jimyu15/Jim-DCC/Hardware/DCC-headlight-V2.pdf

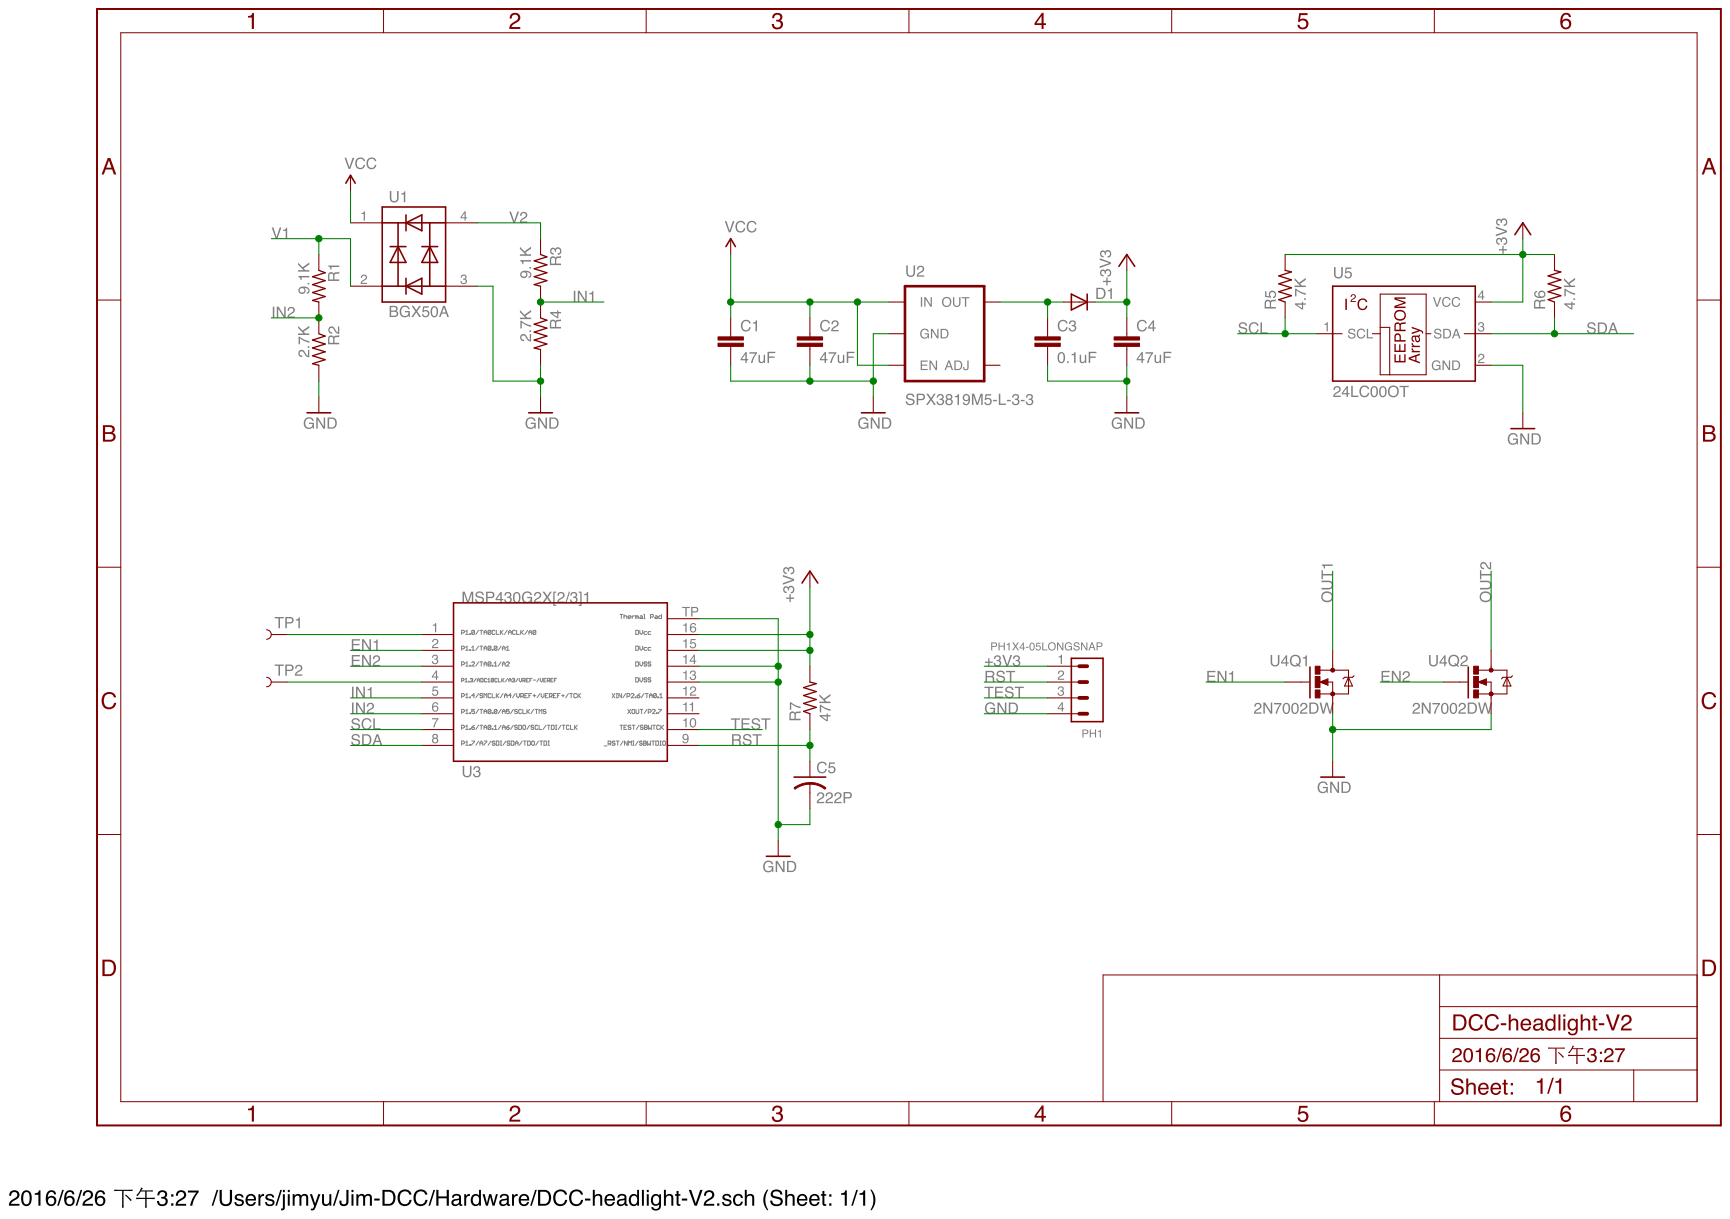
[picture p4: page 1]
