jimyu15/Jim-DCC/Hardware/DCC-light.pdf

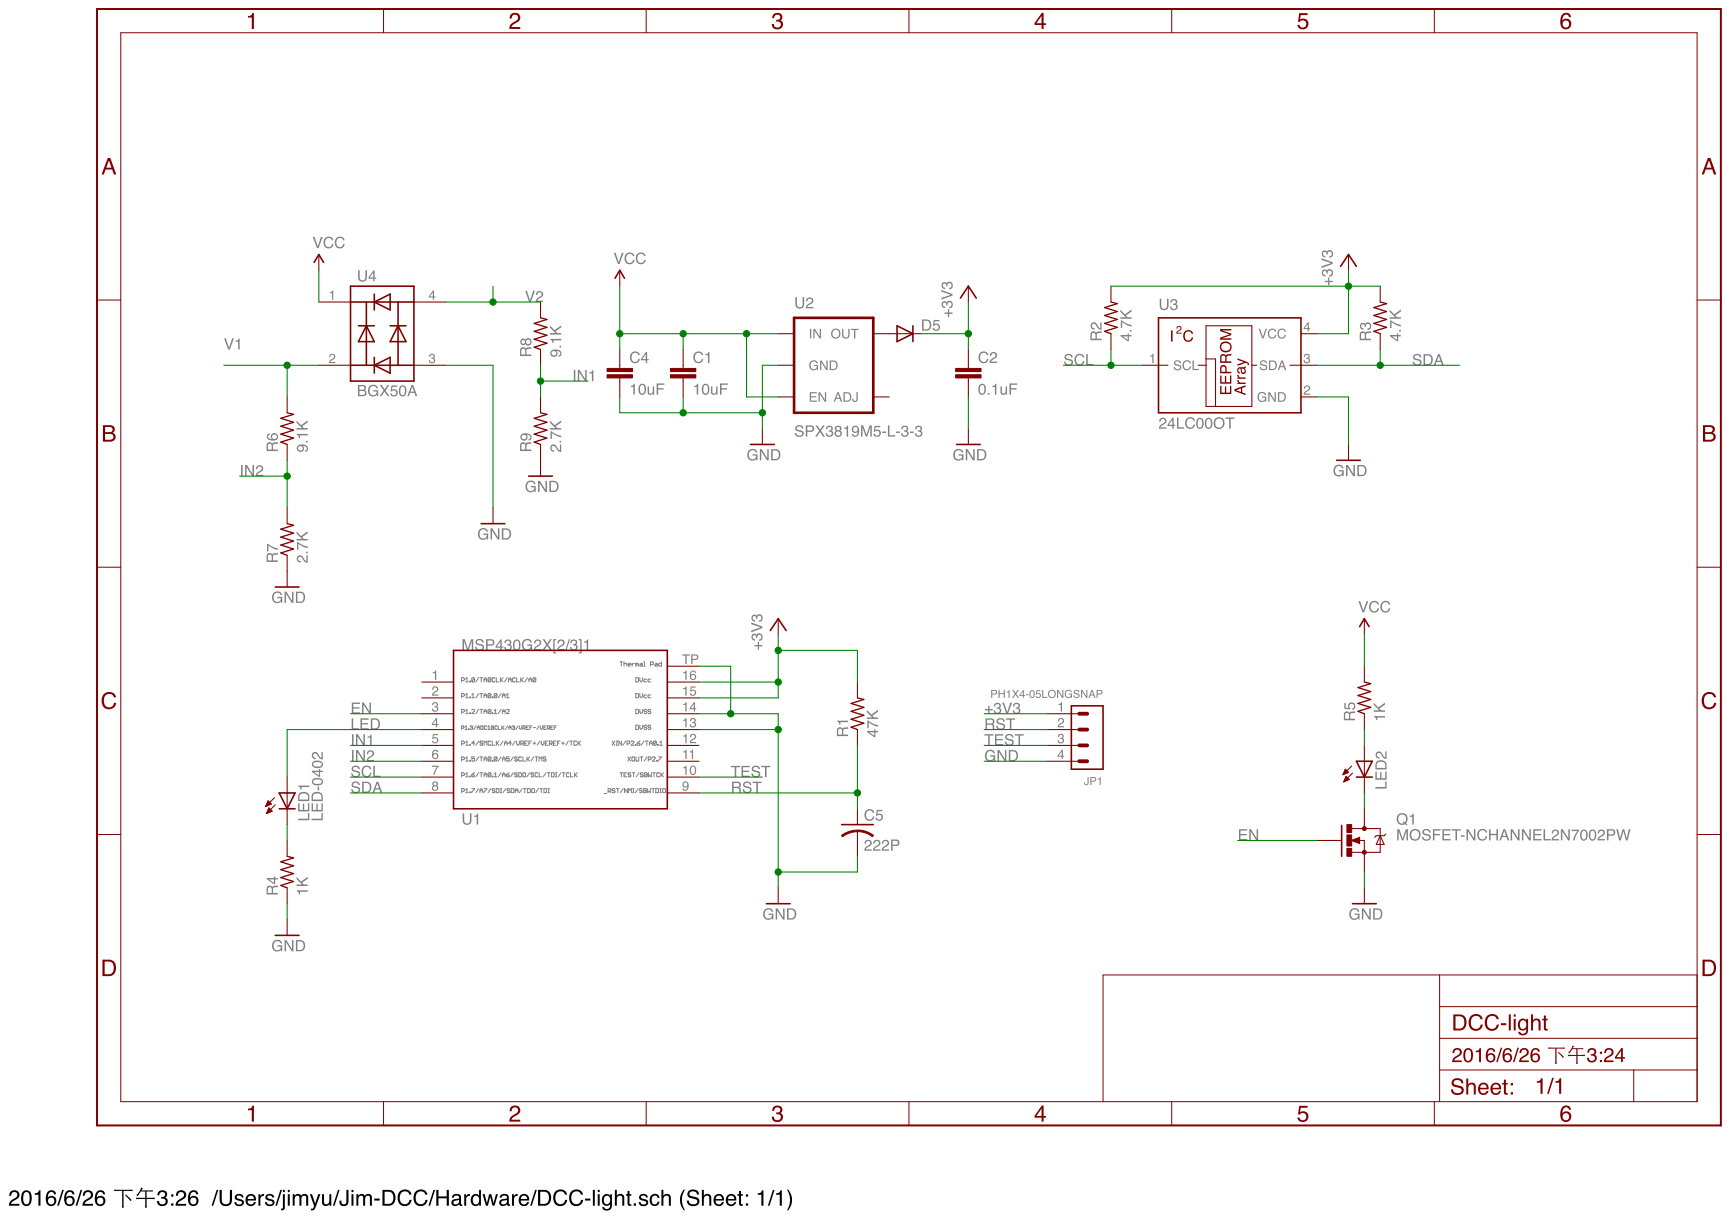
[picture p5: page 1]
