jimyu15/Jim-DCC/Hardware/DCC-motor.pdf

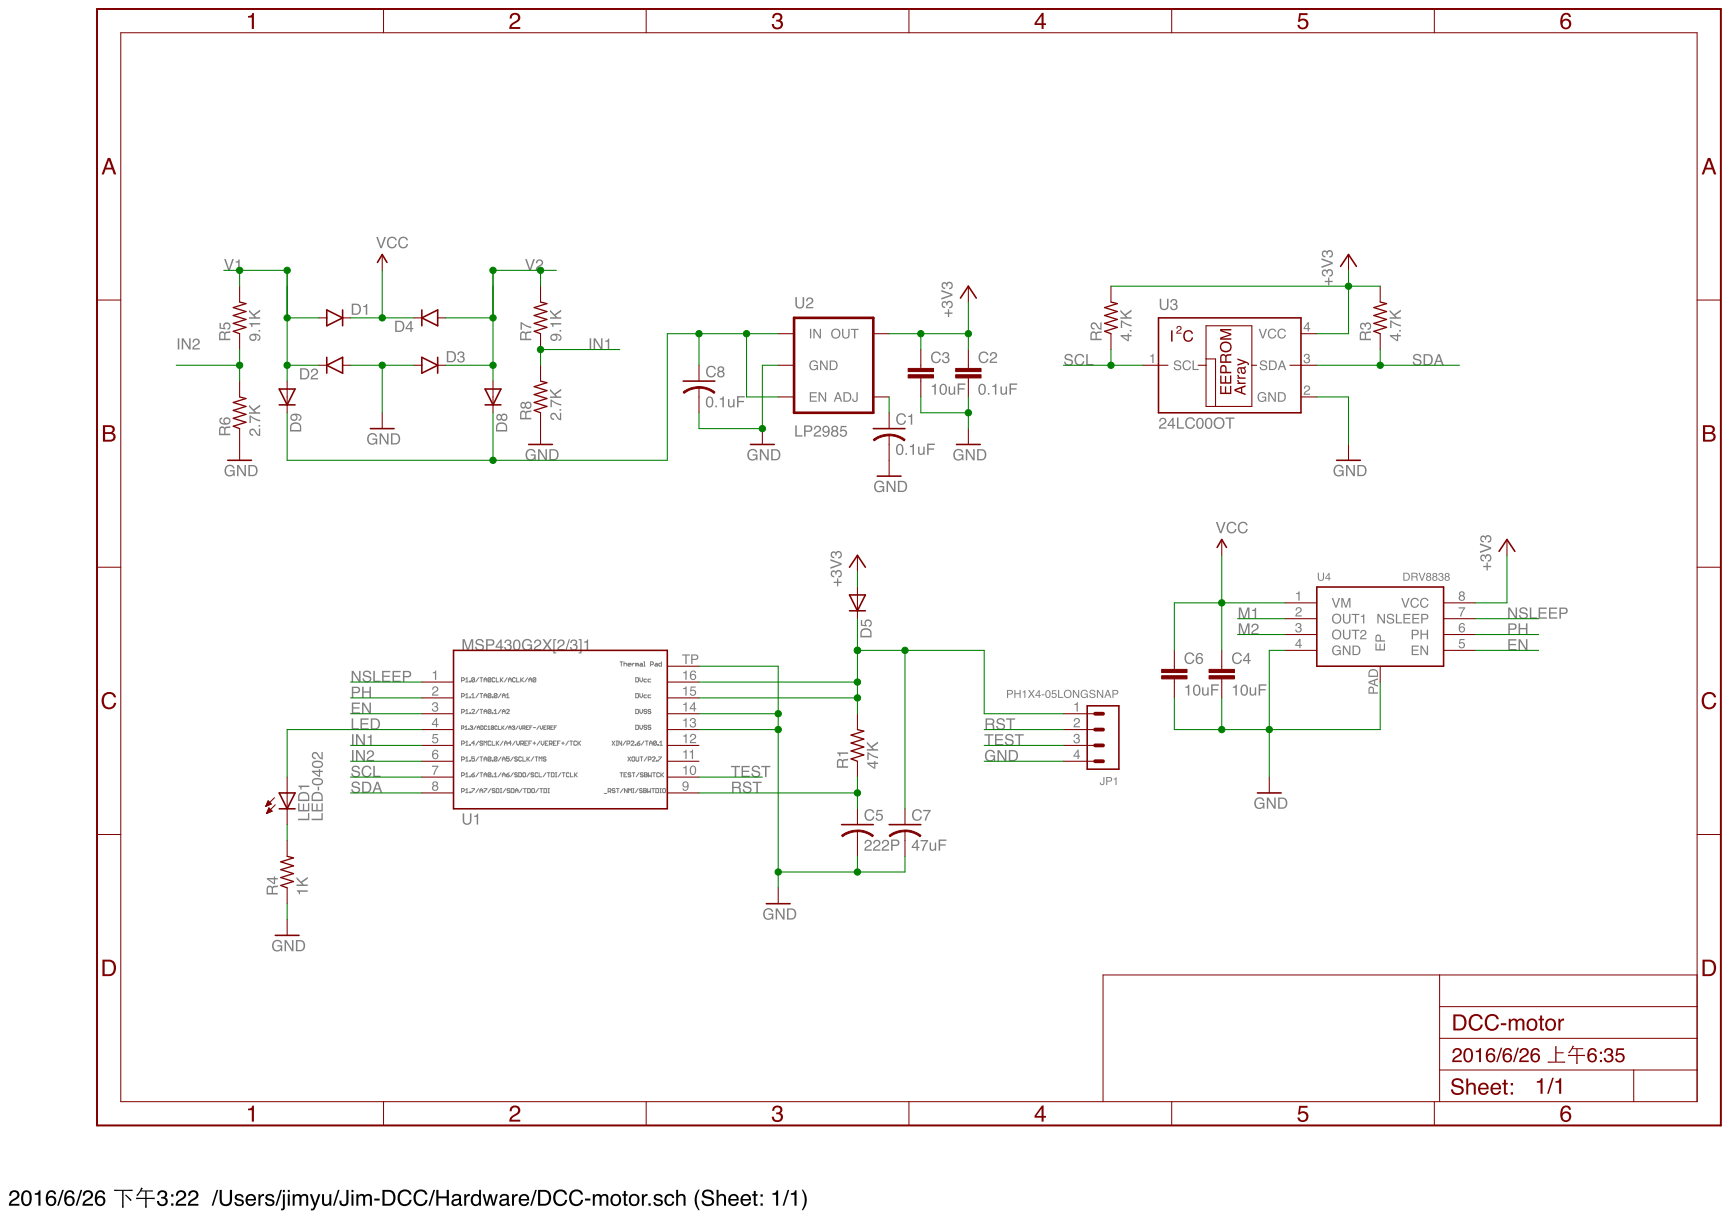
[picture p6: page 1]
