jimyu15/Jim-DCC/Hardware/DCC-command-center-V2.brd

## EAGLE design Hardware/DCC-command-center-V2.brd (2016-06-26)

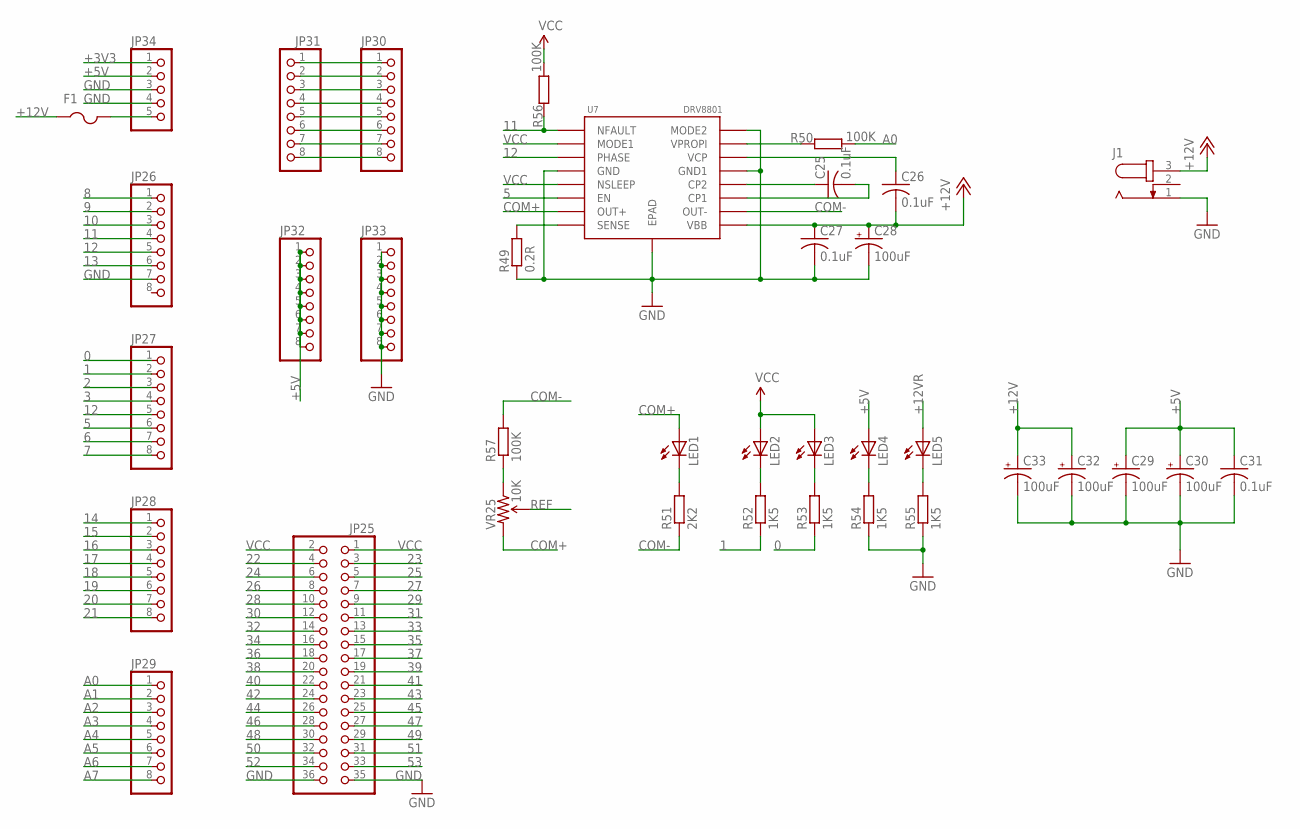
[picture p7: schematic DCC-command-center-V2.sch, sheet 1]

Parts:
C25, C26, C27, C31: 0.1uF; C0603
C28, C29, C30, C32, C33: 100uF; 153CLV-0505
F1: PTCFUSE-1812; 1812
J1: RAPC7120; RAPC712
JP25: PINHD-2X18_2.54; 2X18
JP26, JP27, JP28, JP29, JP30, JP31, JP32, JP33: PINHD-1X08_2.54-S; 1X08-S
JP34: PINHD-1X05_2.54-S; 1X05-S
LED1, LED2, LED3, LED4, LED5: LEDCHIP-LED0603; CHIP-LED0603
R49: 0.2R; R2512
R50, R56, R57: 100K; R0603
R51: 2K2; R0603
R52, R53, R54, R55: 1K5; R0603
U7: DRV8801; HTSSOP16
VR25: 10K; TRIMPOT-3MM-2

Connections:
0: JP27.1, R53.1
1: JP27.2, R52.1
2: JP27.3
3: JP27.4
5: JP27.6, U7.P$6 (EN)
6: JP27.7
7: JP27.8
8: JP26.1
9: JP26.2
10: JP26.3
11: JP26.4, R56.2, U7.P$1 (NFAULT)
12: JP26.5, JP27.5, U7.P$3 (PHASE)
13: JP26.6
14: JP28.1
15: JP28.2
16: JP28.3
17: JP28.4
18: JP28.5
19: JP28.6
20: JP28.7
21: JP28.8
22: JP25.4; also elsewhere on the board
23: JP25.3; also elsewhere on the board
24: JP25.6; also elsewhere on the board
25: JP25.5; also elsewhere on the board
26: JP25.8; also elsewhere on the board
27: JP25.7; also elsewhere on the board
28: JP25.10; also elsewhere on the board
29: JP25.9; also elsewhere on the board
30: JP25.12; also elsewhere on the board
31: JP25.11; also elsewhere on the board
32: JP25.14; also elsewhere on the board
33: JP25.13; also elsewhere on the board
34: JP25.16; also elsewhere on the board
35: JP25.15; also elsewhere on the board
36: JP25.18; also elsewhere on the board
37: JP25.17; also elsewhere on the board
38: JP25.20; also elsewhere on the board
39: JP25.19; also elsewhere on the board
40: JP25.22; also elsewhere on the board
41: JP25.21; also elsewhere on the board
42: JP25.24; also elsewhere on the board
43: JP25.23; also elsewhere on the board
44: JP25.26; also elsewhere on the board
45: JP25.25; also elsewhere on the board
46: JP25.28
47: JP25.27
48: JP25.30
49: JP25.29
50: JP25.32
51: JP25.31
52: JP25.34
53: JP25.33
+3V3: JP34.1
+5V: C29.+, C30.+, C31.1, JP32.1, JP32.2, JP32.3, JP32.4, JP32.5, JP32.6, JP32.7, JP32.8, JP34.2, LED4.A
+12V: C26.2, C27.1, C28.+, C32.+, C33.+, F1.1, J1.3, U7.P$9 (VBB)
+12VR: F1.2, JP34.5, LED5.A
A0: JP29.1, R50.1
A1: JP29.2
A2: JP29.3
A3: JP29.4
A4: JP29.5
A5: JP29.6
A6: JP29.7
A7: JP29.8
COM+: LED1.A, U7.P$7 (OUT+), VR25.3 (CW); also elsewhere on the board
COM-: R51.1, R57.2, U7.P$10 (OUT-); also elsewhere on the board
GND: C27.2, C28.-, C29.-, C30.-, C31.2, C32.-, C33.-, J1.1, JP25.35, JP25.36, JP26.7, JP33.1, JP33.2, JP33.3, JP33.4, JP33.5, JP33.6, JP33.7, JP33.8, JP34.3, JP34.4, R49.1, R54.1, R55.1, U7.P$4 (GND), U7.P$13 (GND1), U7.P$16 (MODE2), U7.P$17 (EPAD); also elsewhere on the board
unnamed: JP30.1, JP31.1
unnamed: JP30.2, JP31.2
unnamed: JP30.3, JP31.3
unnamed: JP30.4, JP31.4
unnamed: JP30.5, JP31.5
unnamed: JP30.6, JP31.6
unnamed: JP30.7, JP31.7
unnamed: JP30.8, JP31.8
unnamed: R49.2, U7.P$8 (SENSE)
unnamed: C25.1, U7.P$12 (CP2)
unnamed: C25.2, U7.P$11 (CP1)
unnamed: C26.1, U7.P$14 (VCP)
unnamed: R57.1, VR25.1 (CCW)
unnamed: R50.2, U7.P$15 (VPROPI)
unnamed: LED1.C, R51.2
unnamed: LED2.C, R52.2
unnamed: LED3.C, R53.2
unnamed: LED4.C, R54.2
unnamed: LED5.C, R55.2
REF: VR25.2 (WIPER); also elsewhere on the board
VCC: JP25.1, JP25.2, LED2.A, LED3.A, R56.1, U7.P$2 (MODE1), U7.P$5 (NSLEEP); also elsewhere on the board

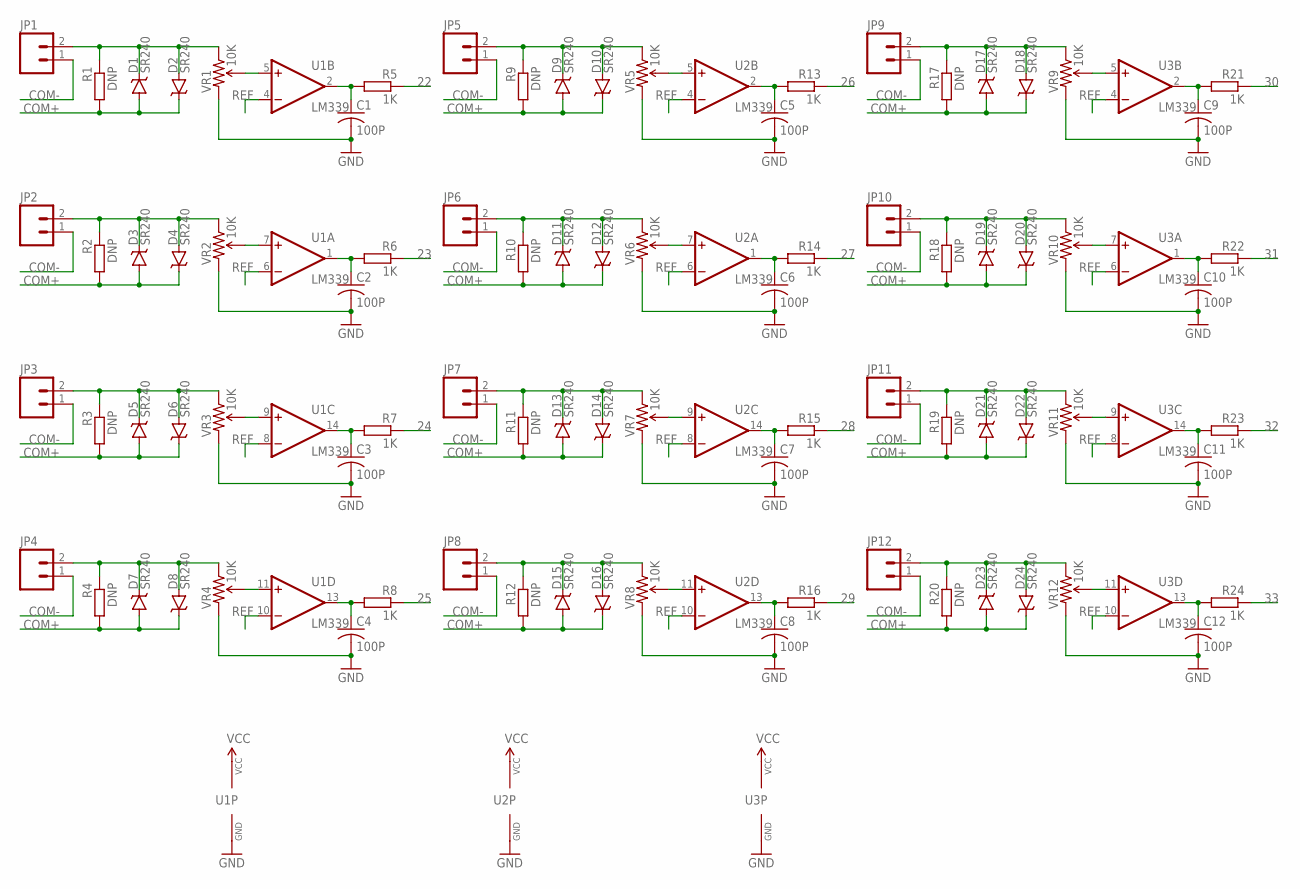
[picture p8: schematic DCC-command-center-V2.sch, sheet 2]

Parts:
C1, C2, C3, C4, C5, C6, C7, C8, C9, C10, C11, C12: 100P; C0603
D1, D2, D3, D4, D5, D6, D7, D8, D9, D10, D11, D12, D13, D14, D15, D16, D17, D18, D19, D20, D21, D22, D23, D24: SR240; SMA-DIODE
JP1, JP2, JP3, JP4, JP5, JP6, JP7, JP8, JP9, JP10, JP11, JP12: M02POGO_PIN_HOLES_ONLY; 1X02_PP_HOLES_ONLY
R1, R2, R3, R4, R9, R10, R11, R12, R17, R18, R19, R20: DNP; R0603
R5, R6, R7, R8, R13, R14, R15, R16, R21, R22, R23, R24: 1K; R0603
U1, U2, U3: LM339; TSSOP-14
VR1, VR2, VR3, VR4, VR5, VR6, VR7, VR8, VR9, VR10, VR11, VR12: 10K; TRIMPOT-3MM-2

Connections:
22: R5.1; also elsewhere on the board
23: R6.1; also elsewhere on the board
24: R7.1; also elsewhere on the board
25: R8.1; also elsewhere on the board
26: R13.1; also elsewhere on the board
27: R14.1; also elsewhere on the board
28: R15.1; also elsewhere on the board
29: R16.1; also elsewhere on the board
30: R21.1; also elsewhere on the board
31: R22.1; also elsewhere on the board
32: R23.1; also elsewhere on the board
33: R24.1; also elsewhere on the board
COM+: D1.A, D2.C, D3.A, D4.C, D5.A, D6.C, D7.A, D8.C, D9.A, D10.C, D11.A, D12.C, D13.A, D14.C, D15.A, D16.C, D17.A, D18.C, D19.A, D20.C, D21.A, D22.C, D23.A, D24.C, R1.2, R2.2, R3.2, R4.2, R9.2, R10.2, R11.2, R12.2, R17.2, R18.2, R19.2, R20.2; also elsewhere on the board
COM-: JP1.1, JP2.1, JP3.1, JP4.1, JP5.1, JP6.1, JP7.1, JP8.1, JP9.1, JP10.1, JP11.1, JP12.1; also elsewhere on the board
GND: C1.2, C2.2, C3.2, C4.2, C5.2, C6.2, C7.2, C8.2, C9.2, C10.2, C11.2, C12.2, U1.12 (GND), U2.12 (GND), U3.12 (GND), VR1.3 (CW), VR2.3 (CW), VR3.3 (CW), VR4.3 (CW), VR5.3 (CW), VR6.3 (CW), VR7.3 (CW), VR8.3 (CW), VR9.3 (CW), VR10.3 (CW), VR11.3 (CW), VR12.3 (CW); also elsewhere on the board
JP1: D1.C, D2.A, JP1.2, R1.1, VR1.1 (CCW)
JP2: D3.C, D4.A, JP2.2, R2.1, VR2.1 (CCW)
JP3: D5.C, D6.A, JP3.2, R3.1, VR3.1 (CCW)
JP4: D7.C, D8.A, JP4.2, R4.1, VR4.1 (CCW)
JP5: D9.C, D10.A, JP5.2, R9.1, VR5.1 (CCW)
JP6: D11.C, D12.A, JP6.2, R10.1, VR6.1 (CCW)
JP7: D13.C, D14.A, JP7.2, R11.1, VR7.1 (CCW)
JP8: D15.C, D16.A, JP8.2, R12.1, VR8.1 (CCW)
JP9: D17.C, D18.A, JP9.2, R17.1, VR9.1 (CCW)
JP10: D19.C, D20.A, JP10.2, R18.1, VR10.1 (CCW)
JP11: D21.C, D22.A, JP11.2, R19.1, VR11.1 (CCW)
JP12: D23.C, D24.A, JP12.2, R20.1, VR12.1 (CCW)
OP1: C1.1, R5.2, U1.2 (OUT)
OP2: C2.1, R6.2, U1.1 (OUT)
OP3: C3.1, R7.2, U1.14 (OUT)
OP4: C4.1, R8.2, U1.13 (OUT)
OP5: C5.1, R13.2, U2.2 (OUT)
OP6: C6.1, R14.2, U2.1 (OUT)
OP7: C7.1, R15.2, U2.14 (OUT)
OP8: C8.1, R16.2, U2.13 (OUT)
OP9: C9.1, R21.2, U3.2 (OUT)
OP10: C10.1, R22.2, U3.1 (OUT)
OP11: C11.1, R23.2, U3.14 (OUT)
OP12: C12.1, R24.2, U3.13 (OUT)
REF: U1.4 (-IN), U1.6 (-IN), U1.8 (-IN), U1.10 (-IN), U2.4 (-IN), U2.6 (-IN), U2.8 (-IN), U2.10 (-IN), U3.4 (-IN), U3.6 (-IN), U3.8 (-IN), U3.10 (-IN); also elsewhere on the board
VCC: U1.3 (VCC), U2.3 (VCC), U3.3 (VCC); also elsewhere on the board
VR1: U1.5 (+IN), VR1.2 (WIPER)
VR2: U1.7 (+IN), VR2.2 (WIPER)
VR3: U1.9 (+IN), VR3.2 (WIPER)
VR4: U1.11 (+IN), VR4.2 (WIPER)
VR5: U2.5 (+IN), VR5.2 (WIPER)
VR6: U2.7 (+IN), VR6.2 (WIPER)
VR7: U2.9 (+IN), VR7.2 (WIPER)
VR8: U2.11 (+IN), VR8.2 (WIPER)
VR9: U3.5 (+IN), VR9.2 (WIPER)
VR10: U3.7 (+IN), VR10.2 (WIPER)
VR11: U3.9 (+IN), VR11.2 (WIPER)
VR12: U3.11 (+IN), VR12.2 (WIPER)

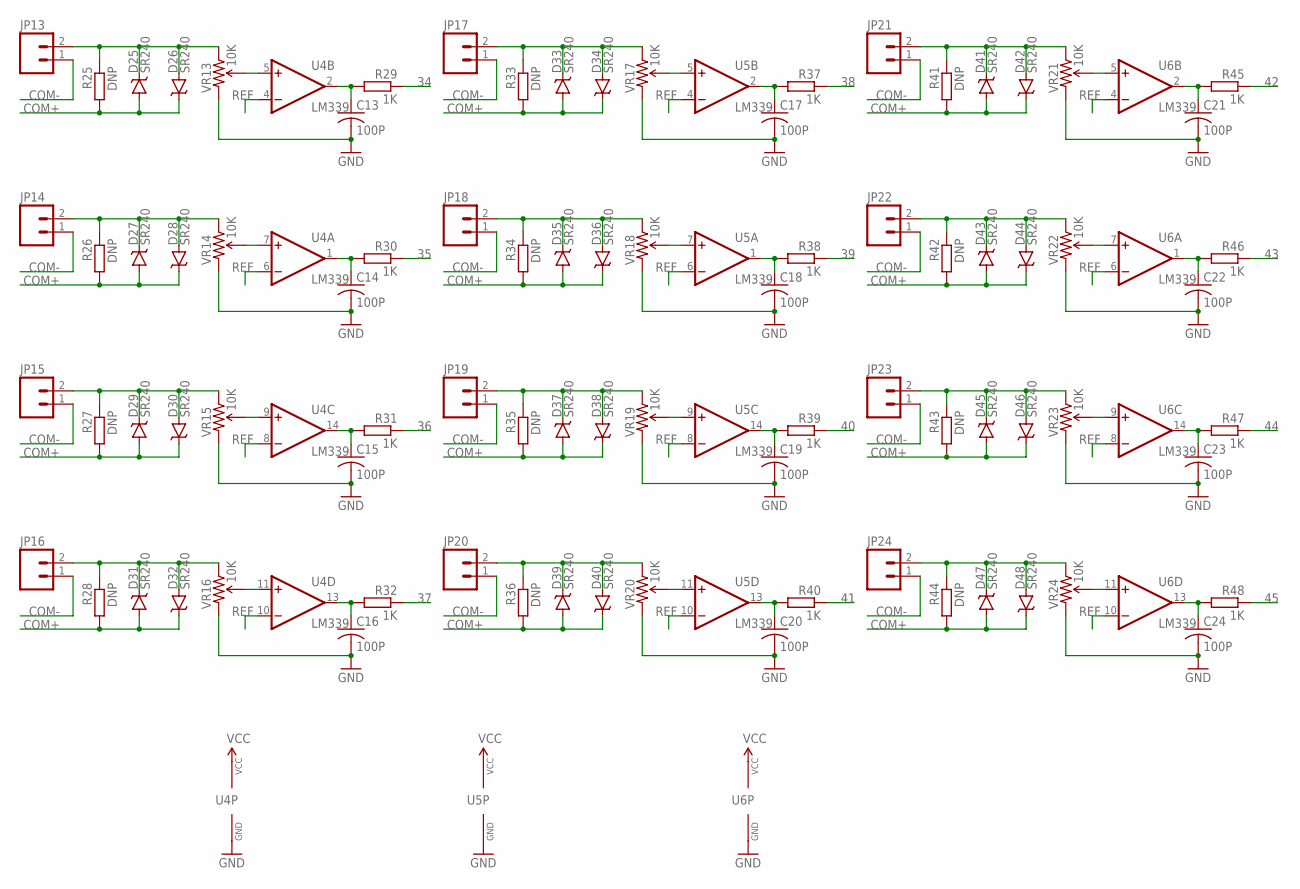
[picture p9: schematic DCC-command-center-V2.sch, sheet 3]

Parts:
C13, C14, C15, C16, C17, C18, C19, C20, C21, C22, C23, C24: 100P; C0603
D25, D26, D27, D28, D29, D30, D31, D32, D33, D34, D35, D36, D37, D38, D39, D40, D41, D42, D43, D44, D45, D46, D47, D48: SR240; SMA-DIODE
JP13, JP14, JP15, JP16, JP17, JP18, JP19, JP20, JP21, JP22, JP23, JP24: M02POGO_PIN_HOLES_ONLY; 1X02_PP_HOLES_ONLY
R25, R26, R27, R28, R33, R34, R35, R36, R41, R42, R43, R44: DNP; R0603
R29, R30, R31, R32, R37, R38, R39, R40, R45, R46, R47, R48: 1K; R0603
U4, U5, U6: LM339; TSSOP-14
VR13, VR14, VR15, VR16, VR17, VR18, VR19, VR20, VR21, VR22, VR23, VR24: 10K; TRIMPOT-3MM-2

Connections:
34: R29.1; also elsewhere on the board
35: R30.1; also elsewhere on the board
36: R31.1; also elsewhere on the board
37: R32.1; also elsewhere on the board
38: R37.1; also elsewhere on the board
39: R38.1; also elsewhere on the board
40: R39.1; also elsewhere on the board
41: R40.1; also elsewhere on the board
42: R45.1; also elsewhere on the board
43: R46.1; also elsewhere on the board
44: R47.1; also elsewhere on the board
45: R48.1; also elsewhere on the board
COM+: D25.A, D26.C, D27.A, D28.C, D29.A, D30.C, D31.A, D32.C, D33.A, D34.C, D35.A, D36.C, D37.A, D38.C, D39.A, D40.C, D41.A, D42.C, D43.A, D44.C, D45.A, D46.C, D47.A, D48.C, R25.2, R26.2, R27.2, R28.2, R33.2, R34.2, R35.2, R36.2, R41.2, R42.2, R43.2, R44.2; also elsewhere on the board
COM-: JP13.1, JP14.1, JP15.1, JP16.1, JP17.1, JP18.1, JP19.1, JP20.1, JP21.1, JP22.1, JP23.1, JP24.1; also elsewhere on the board
GND: C13.2, C14.2, C15.2, C16.2, C17.2, C18.2, C19.2, C20.2, C21.2, C22.2, C23.2, C24.2, U4.12 (GND), U5.12 (GND), U6.12 (GND), VR13.3 (CW), VR14.3 (CW), VR15.3 (CW), VR16.3 (CW), VR17.3 (CW), VR18.3 (CW), VR19.3 (CW), VR20.3 (CW), VR21.3 (CW), VR22.3 (CW), VR23.3 (CW), VR24.3 (CW); also elsewhere on the board
JP13: D25.C, D26.A, JP13.2, R25.1, VR13.1 (CCW)
JP14: D27.C, D28.A, JP14.2, R26.1, VR14.1 (CCW)
JP15: D29.C, D30.A, JP15.2, R27.1, VR15.1 (CCW)
JP16: D31.C, D32.A, JP16.2, R28.1, VR16.1 (CCW)
JP17: D33.C, D34.A, JP17.2, R33.1, VR17.1 (CCW)
JP18: D35.C, D36.A, JP18.2, R34.1, VR18.1 (CCW)
JP19: D37.C, D38.A, JP19.2, R35.1, VR19.1 (CCW)
JP20: D39.C, D40.A, JP20.2, R36.1, VR20.1 (CCW)
JP21: D41.C, D42.A, JP21.2, R41.1, VR21.1 (CCW)
JP22: D43.C, D44.A, JP22.2, R42.1, VR22.1 (CCW)
JP23: D45.C, D46.A, JP23.2, R43.1, VR23.1 (CCW)
JP24: D47.C, D48.A, JP24.2, R44.1, VR24.1 (CCW)
OP13: C13.1, R29.2, U4.2 (OUT)
OP14: C14.1, R30.2, U4.1 (OUT)
OP15: C15.1, R31.2, U4.14 (OUT)
OP16: C16.1, R32.2, U4.13 (OUT)
OP17: C17.1, R37.2, U5.2 (OUT)
OP18: C18.1, R38.2, U5.1 (OUT)
OP19: C19.1, R39.2, U5.14 (OUT)
OP20: C20.1, R40.2, U5.13 (OUT)
OP21: C21.1, R45.2, U6.2 (OUT)
OP22: C22.1, R46.2, U6.1 (OUT)
OP23: C23.1, R47.2, U6.14 (OUT)
OP24: C24.1, R48.2, U6.13 (OUT)
REF: U4.4 (-IN), U4.6 (-IN), U4.8 (-IN), U4.10 (-IN), U5.4 (-IN), U5.6 (-IN), U5.8 (-IN), U5.10 (-IN), U6.4 (-IN), U6.6 (-IN), U6.8 (-IN), U6.10 (-IN); also elsewhere on the board
VCC: U4.3 (VCC), U5.3 (VCC), U6.3 (VCC); also elsewhere on the board
VR13: U4.5 (+IN), VR13.2 (WIPER)
VR14: U4.7 (+IN), VR14.2 (WIPER)
VR15: U4.9 (+IN), VR15.2 (WIPER)
VR16: U4.11 (+IN), VR16.2 (WIPER)
VR17: U5.5 (+IN), VR17.2 (WIPER)
VR18: U5.7 (+IN), VR18.2 (WIPER)
VR19: U5.9 (+IN), VR19.2 (WIPER)
VR20: U5.11 (+IN), VR20.2 (WIPER)
VR21: U6.5 (+IN), VR21.2 (WIPER)
VR22: U6.7 (+IN), VR22.2 (WIPER)
VR23: U6.9 (+IN), VR23.2 (WIPER)
VR24: U6.11 (+IN), VR24.2 (WIPER)

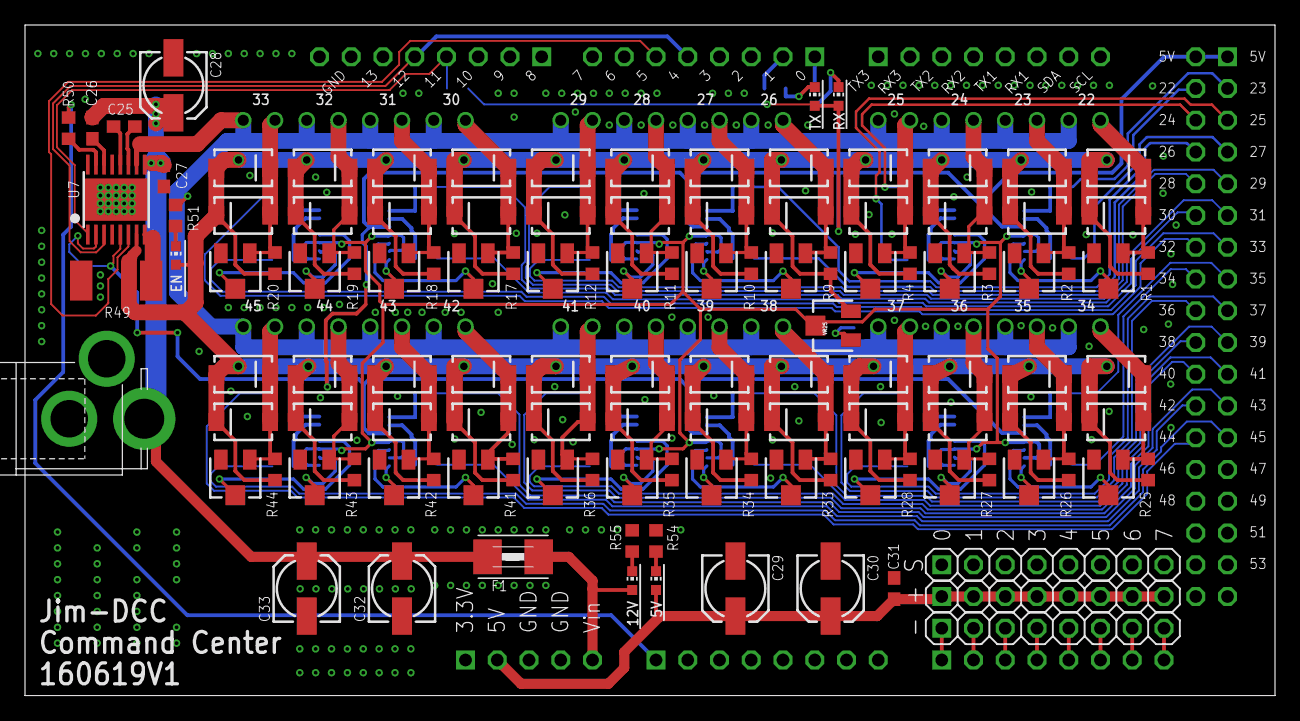
[picture p10: board DCC-command-center-V2.brd from above]

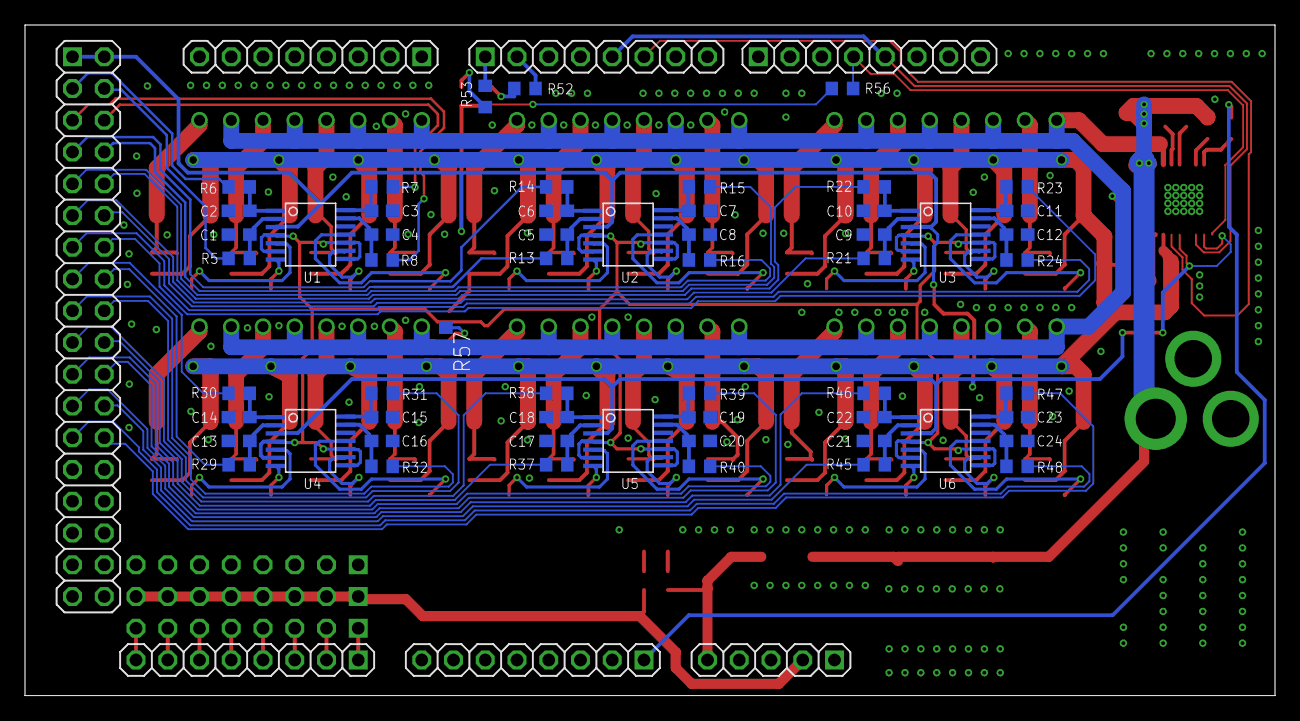
[picture p11: board DCC-command-center-V2.brd from below]

Board: 2 copper layers, 100.0 x 53.6 mm, 211 parts (66 on the bottom side), 129 nets.
