jimyu15/Jim-DCC/Hardware/DCC-motor.brd

## EAGLE design Hardware/DCC-motor.brd (2016-06-26)

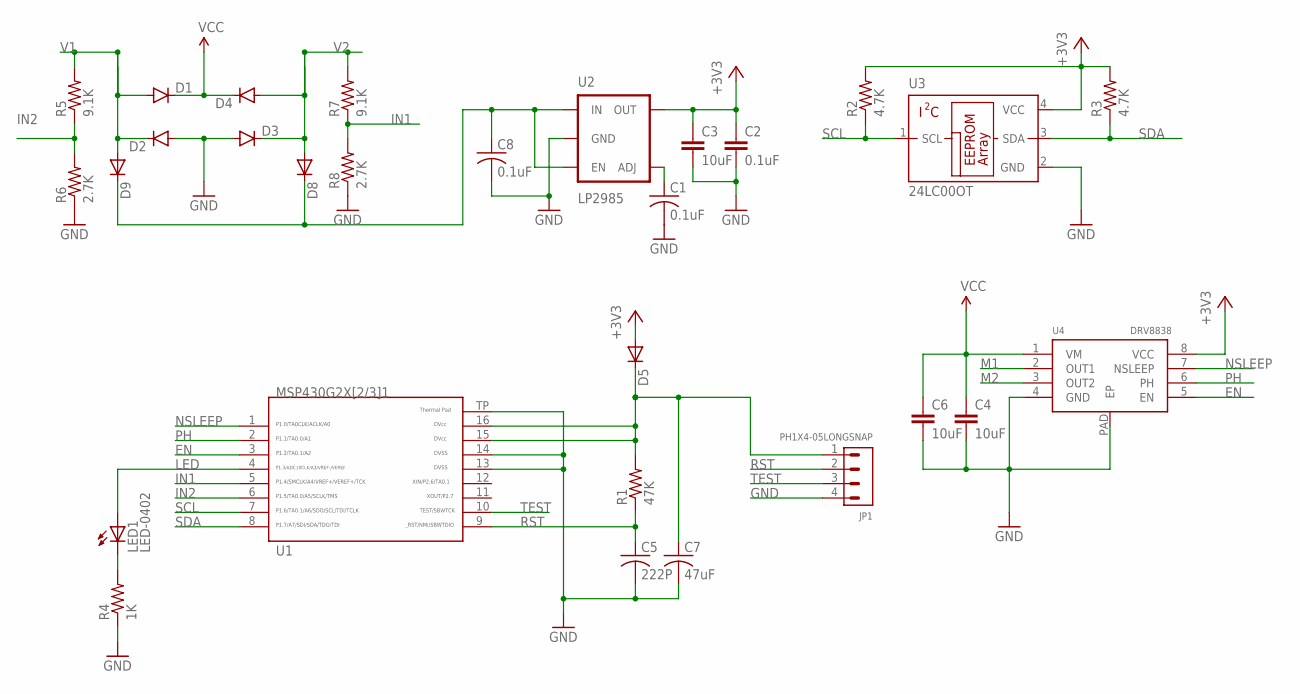
[picture p12: schematic DCC-motor.sch]

Parts:
C1, C8: 0.1uF; C0402
C2: 0.1uF; 0603-CAP
C3, C4, C6: 10uF; 0603-CAP
C5: 222P; C0402
C7: 47uF; C0402
D1, D2, D3, D4: DIODESOD123; SOD-123
D5, D8, D9: DIODE-SOD523; SOD523
JP1: PH1X4-05LONGSNAP; PHLS005-1-4
LED1: LED-0402; 0402-LED
R1: 47K; R0402
R2, R3: 4.7K; R0402
R4: 1K; R0402
R5, R7: 9.1K; R0402
R6, R8: 2.7K; R0402
U1: G2X[2/3]1---RSA16; RSA16
U2: LP2985; SOT23-5
U3: 24LC00OT; SOT23-5L
U4: DRV8838; WSON-8-PAD

Connections:
+3V3: C2.1, C3.1, D5.A, R2.2, R3.2, U2.5 (OUT), U3.4 (VCC), U4.8 (VCC)
EN: U1.3, U4.5 (EN)
GND: C1.2, C2.2, C3.2, C4.2, C5.2, C6.2, C7.2, C8.2, D2.A, D3.A, JP1.4, R4.1, R6.1, R8.1, U1.13, U1.14, U1.TP, U2.2 (GND), U3.2 (GND), U4.4 (GND), U4.PAD (EP)
IN1: R7.1, R8.2, U1.5
IN2: R5.1, R6.2, U1.6
LED: LED1.A, U1.4
M1: U4.2 (OUT1)
M2: U4.3 (OUT2)
unnamed: C1.1, U2.4 (ADJ)
unnamed: C8.1, D8.C, D9.C, U2.1 (IN), U2.3 (EN)
unnamed: LED1.C, R4.2
unnamed: C7.1, D5.C, JP1.1, R1.2, U1.15, U1.16
NSLEEP: U1.1, U4.7 (NSLEEP)
PH: U1.2, U4.6 (PH)
RST: C5.1, JP1.2, R1.1, U1.9
SCL: R2.1, U1.7, U3.1 (SCL)
SDA: R3.1, U1.8, U3.3 (SDA)
TEST: JP1.3, U1.10
V1: D1.A, D2.C, D9.A, R5.2
V2: D3.C, D4.A, D8.A, R7.2
VCC: C4.1, C6.1, D1.C, D4.C, U4.1 (VM)

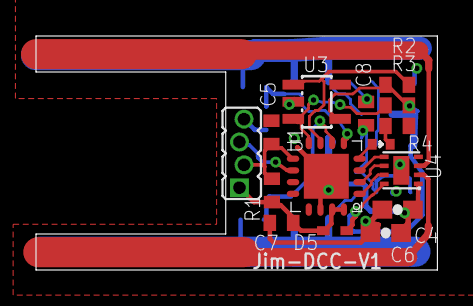
[picture p13: board DCC-motor.brd from above]

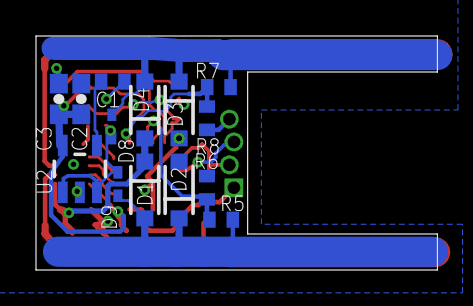
[picture p14: board DCC-motor.brd from below]

Board: 2 copper layers, 22.3 x 13.0 mm, 29 parts (14 on the bottom side), 19 nets.
