jimyu15/Jim-DCC/Hardware/DCC-light.brd

## EAGLE design Hardware/DCC-light.brd (2016-06-26)

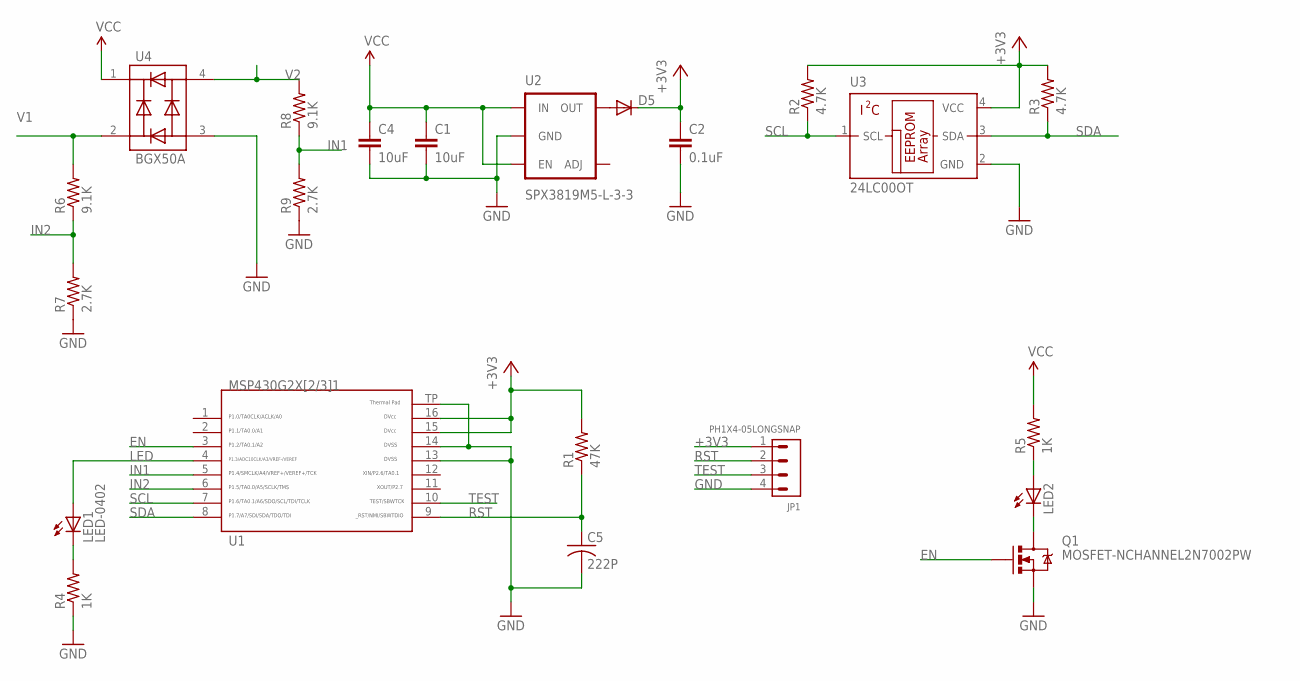
[picture p15: schematic DCC-light.sch]

Parts:
C1: 10uF; 0402-CAP
C2: 0.1uF; 0603-CAP
C4: 10uF; 0603-CAP
C5: 222P; C0402
D5: DIODE-SOD523; SOD523
JP1: PH1X4-05LONGSNAP; PHLS005-1-4
LED1: LED-0402; 0402-LED
LED2: LEDSMT1206; 1206
Q1: MOSFET-NCHANNEL2N7002PW; SOT323
R1: 47K; R0402
R2, R3: 4.7K; R0402
R4: 1K; R0402
R5: 1K; R0603
R6, R8: 9.1K; R0402
R7, R9: 2.7K; R0402
U1: G2X[2/3]1---RSA16; RSA16
U2: SPX3819M5-L-3-3; SOT23-5
U3: 24LC00OT; SOT23-5L
U4: BGX50A; SOT143

Connections:
+3V3: C2.1, D5.C, JP1.1, R1.2, R2.2, R3.2, U1.15, U1.16, U3.4 (VCC)
EN: Q1.1 (G), U1.3
GND: C1.2, C2.2, C4.2, C5.2, JP1.4, Q1.2 (S), R4.1, R7.1, R9.1, U1.13, U1.14, U1.TP, U2.2 (GND), U3.2 (GND), U4.3
IN1: R8.1, R9.2, U1.5
IN2: R6.1, R7.2, U1.6
LED: LED1.A, U1.4
unnamed: LED2.C, Q1.3 (D)
unnamed: LED2.A, R5.1
unnamed: LED1.C, R4.2
unnamed: D5.A, U2.5 (OUT)
RST: C5.1, JP1.2, R1.1, U1.9
SCL: R2.1, U1.7, U3.1 (SCL)
SDA: R3.1, U1.8, U3.3 (SDA)
TEST: JP1.3, U1.10
V1: R6.2, U4.2
V2: R8.2, U4.4
VCC: C1.1, C4.1, R5.2, U2.1 (IN), U2.3 (EN), U4.1

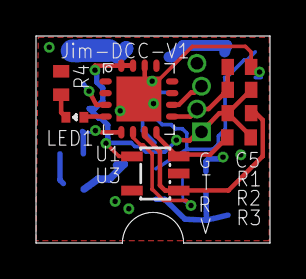
[picture p16: board DCC-light.brd from above]

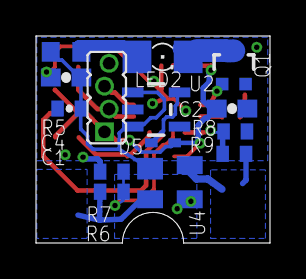
[picture p17: board DCC-light.brd from below]

Board: 2 copper layers, 13.0 x 11.5 mm, 22 parts (14 on the bottom side), 17 nets.
