jimyu15/Jim-DCC/Hardware/DCC-headlight-V2.brd

## EAGLE design Hardware/DCC-headlight-V2.brd (2016-06-26)

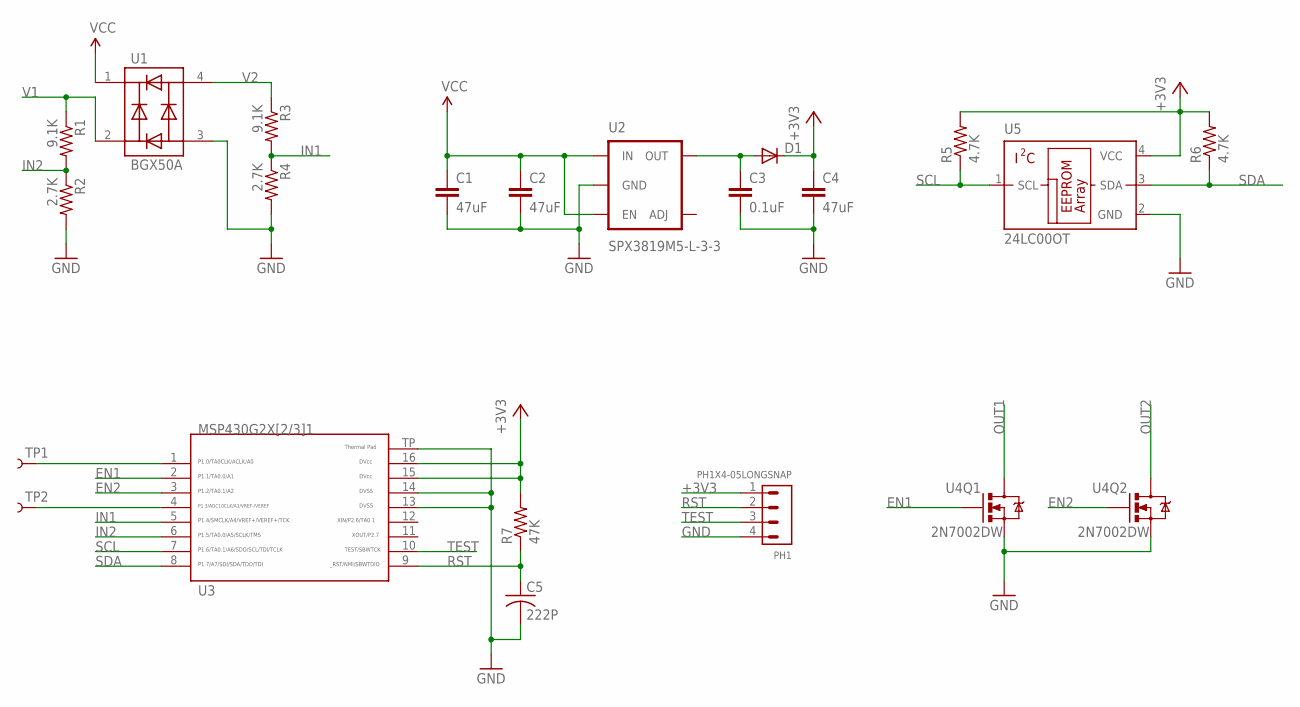
[picture p18: schematic DCC-headlight-V2.sch]

Parts:
C1, C2, C4: 47uF; 0402-CAP
C3: 0.1uF; 0402-CAP
C5: 222P; C0402
D1: DIODE-SOD523; SOD523
PH1: PH1X4-05LONGSNAP; PHLS005-1-4
R1, R3: 9.1K; R0402
R2, R4: 2.7K; R0402
R5, R6: 4.7K; R0402
R7: 47K; R0402
TP1, TP2: TEST-POINT3; PAD.03X.03
U1: BGX50A; SOT143
U2: SPX3819M5-L-3-3; SOT23-5
U3: G2X[2/3]1---RSA16; RSA16
U4: 2N7002DW; SOT363
U5: 24LC00OT; SOT23-5L

Connections:
+3V3: C4.1, D1.C, PH1.1, R5.2, R6.2, R7.2, U3.15, U3.16, U5.4 (VCC)
EN1: U3.2, U4.2 (G)
EN2: U3.3, U4.5 (G)
GND: C1.2, C2.2, C3.2, C4.2, C5.2, PH1.4, R2.2, R4.2, U1.3, U2.2 (GND), U3.13, U3.14, U3.TP, U4.1 (S), U4.4 (S), U5.2 (GND)
IN1: R3.2, R4.1, U3.5
IN2: R1.2, R2.1, U3.6
unnamed: C3.1, D1.A, U2.5 (OUT)
OUT1: U4.6 (D)
OUT2: U4.3 (D)
RST: C5.1, PH1.2, R7.1, U3.9
SCL: R5.1, U3.7, U5.1 (SCL)
SDA: R6.1, U3.8, U5.3 (SDA)
TEST: PH1.3, U3.10
TP1: TP1.P$1, U3.1
TP2: TP2.P$1, U3.4
V1: R1.1, U1.2
V2: R3.1, U1.4
VCC: C1.1, C2.1, U1.1, U2.1 (IN), U2.3 (EN)

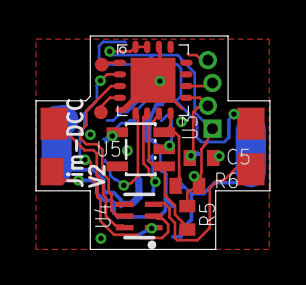
[picture p19: board DCC-headlight-V2.brd from above]

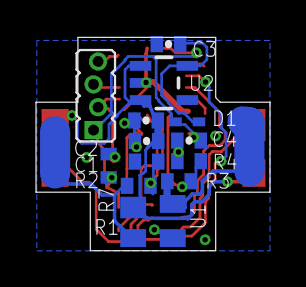
[picture p20: board DCC-headlight-V2.brd from below]

Board: 2 copper layers, 13.0 x 11.9 mm, 21 parts (13 on the bottom side), 16 nets.
