jimyu15/Jim-DCC/DCCpp_Uno/Outputs.h

/**********************************************************************

Outputs.h
COPYRIGHT (c) 2013-2016 Gregg E. Berman

Part of DCC++ BASE STATION for the Arduino

**********************************************************************/

#include "Arduino.h"

#ifndef Outputs_h
#define Outputs_h

struct OutputData {
  byte oStatus;
  int id;
  byte pin; 
  byte iFlag; 
};

struct Output{
  static Output *firstOutput;
  int num;
  struct OutputData data;
  Output *nextOutput;
  void activate(int s);
  static void parse(char *c);
  static Output* get(int);
  static void remove(int);
  static void load();
  static void store();
  static Output *create(int, int, int, int=0);
  static void show(int=0);
  void servo(int, bool);
  static void servo(int, uint8_t, uint8_t);
  static uint8_t refresh(uint8_t*);
}; // Output
  
#endif
