jimyu15/Jim-DCC/(commit log)

2016-06-05 Servo turnout function
2016-06-08 Improve Motor Control
2016-06-09 Improve packet reading and motor control
2016-06-09 Upload hardware design files
    [DCC-headlight.brd, DCC-headlight.sch, DCC-light.brd, DCC-light.sch, DCC-motor.brd, DCC-motor.sch]
2016-06-09 Comparator sensor input and servo turnout supported
2016-06-18 Flashing LED after writing EEPROM
2016-06-25 Sensor bug fixed
2016-06-26 Update hardware design
    [DCC-command-center-V2.brd, DCC-command-center-V2.sch, DCC-headlight-V1.brd, DCC-headlight-V1.sch, DCC-headlight-V2.brd, DCC-headlight-V2.sch, DCC-light.brd, DCC-light.sch]
2016-06-26 Command and storage for servo position configuration
2016-06-26 Update component values
    [DCC-command-center-V2.brd, DCC-command-center-V2.sch]
2016-07-08 Eliminate servo audible noise
    [DCCpp_Uno.ino, Outputs.cpp]
